MaxBMitchell/Faucet-Fatigue-Apparatus/Controller.png

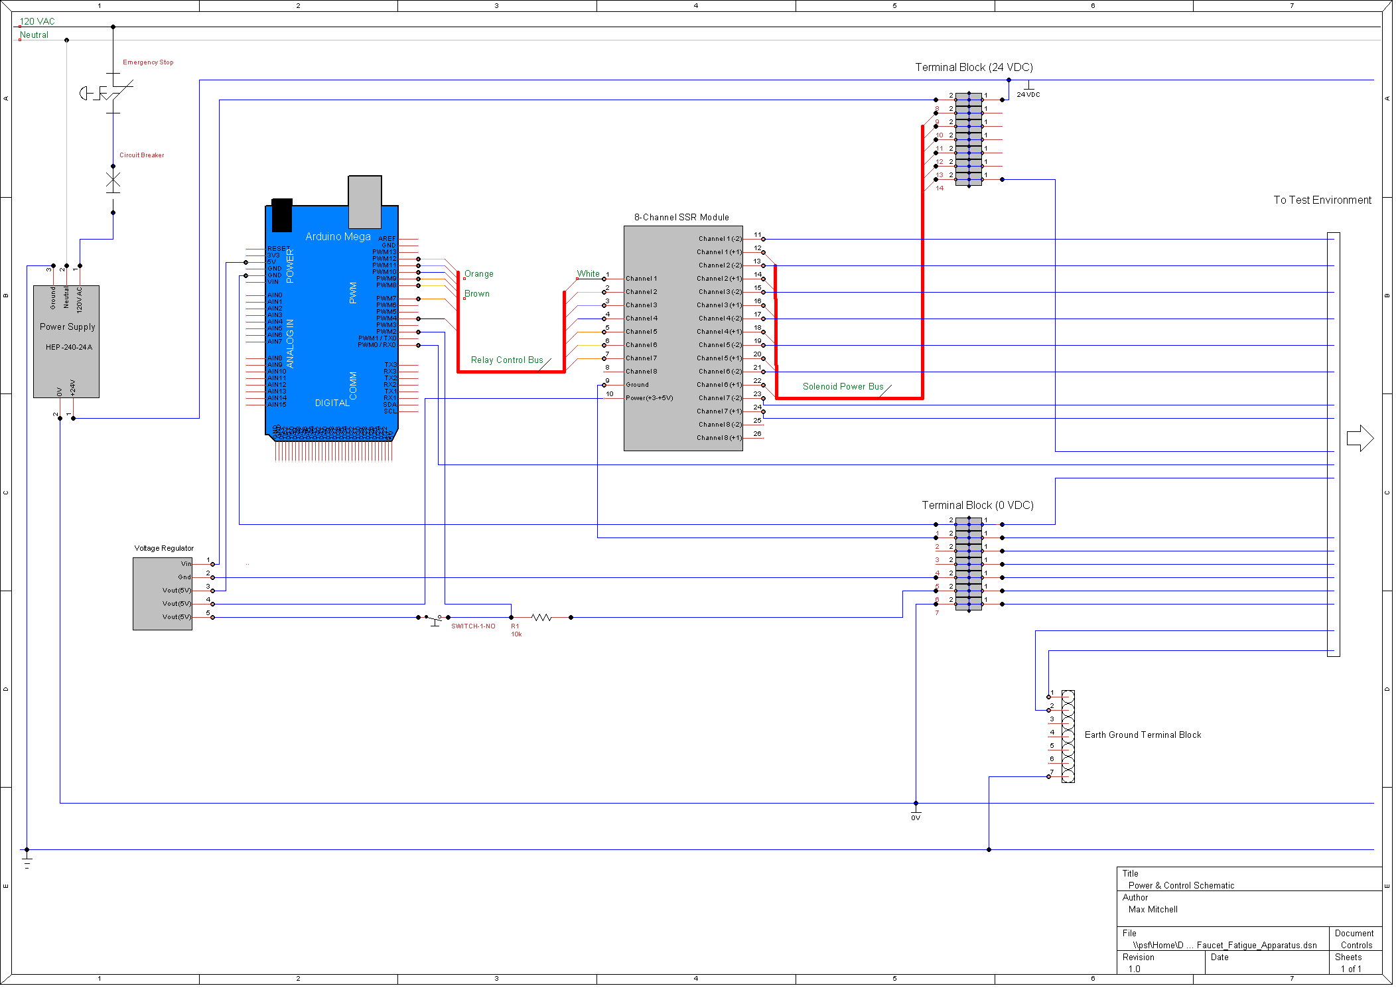
Controller.png
