MaxBMitchell/Faucet-Fatigue-Apparatus/Refill_Cycle.png

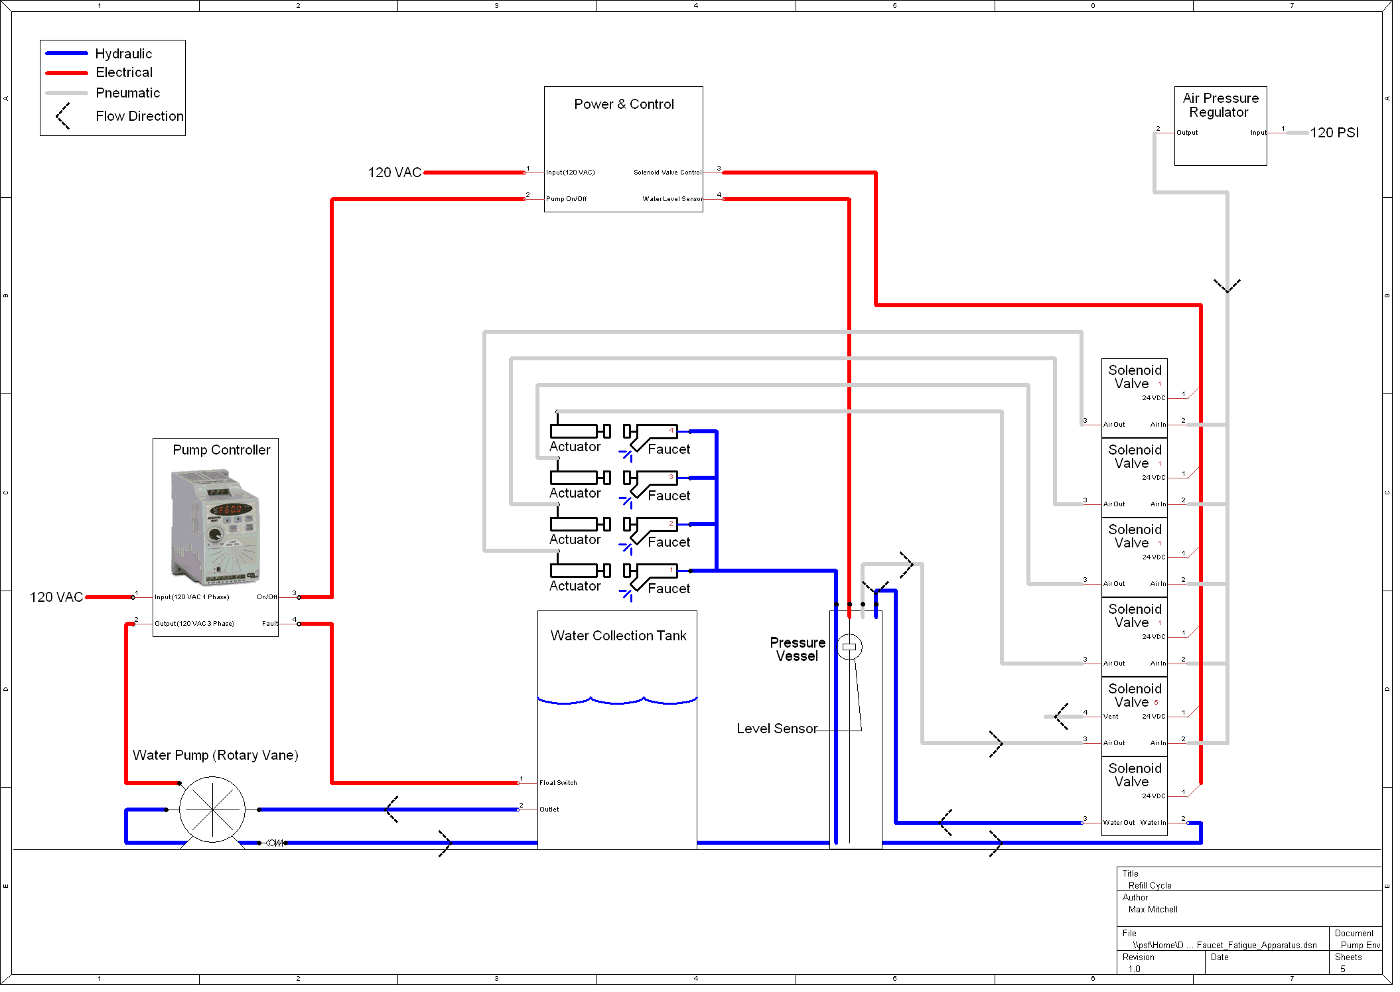
Refill_Cycle.png
