MaxBMitchell/Faucet-Fatigue-Apparatus/Test_Environment.png

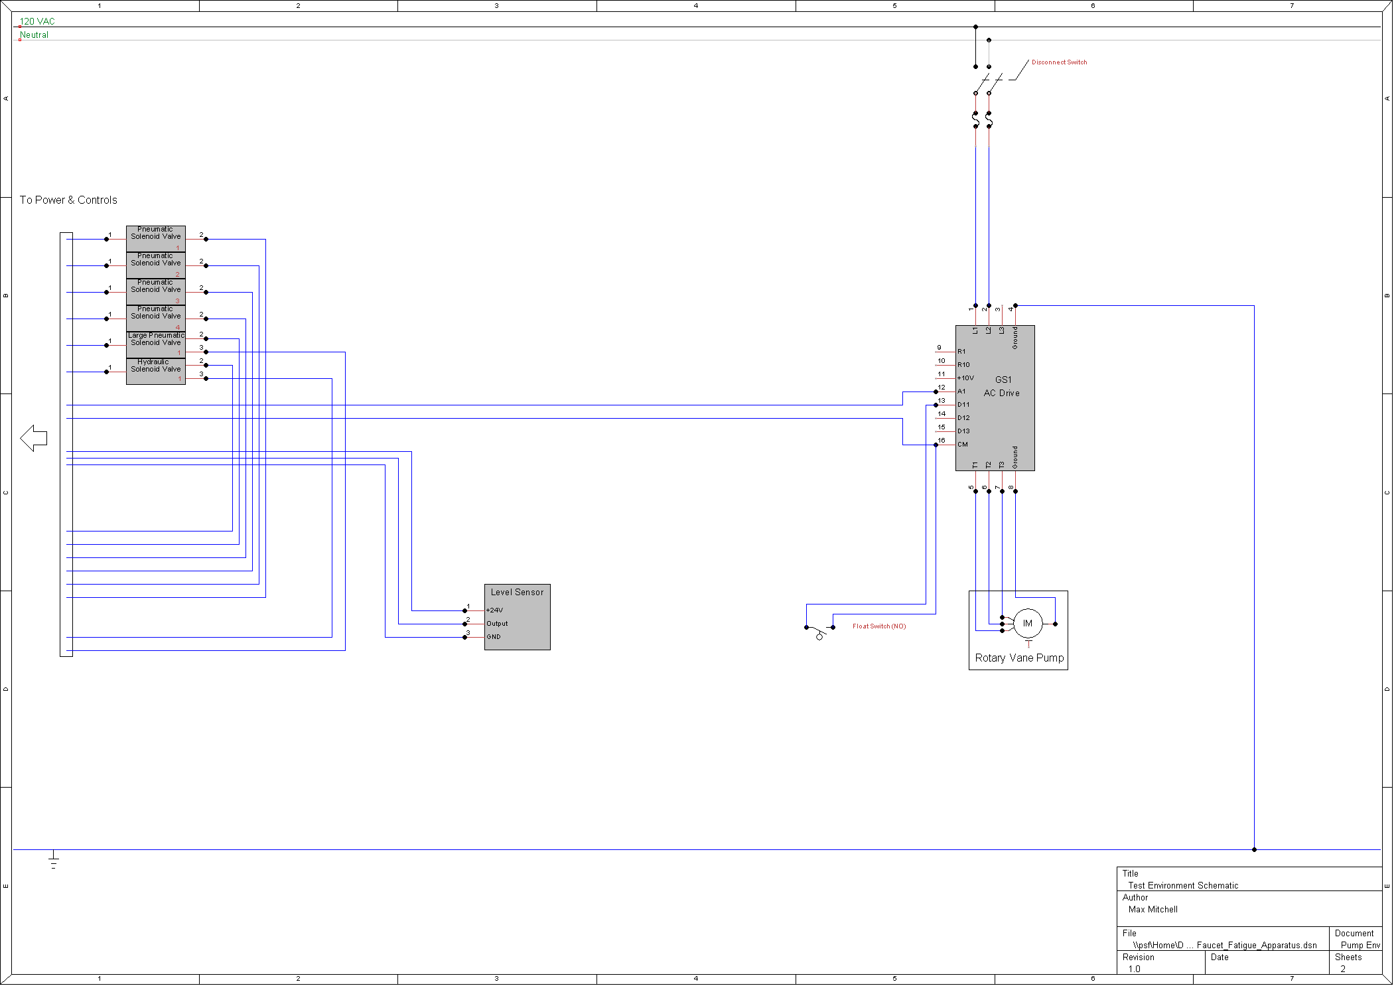
Test_Environment.png
